helioz2000/OM345/OM345A/OM345A1_Back.png

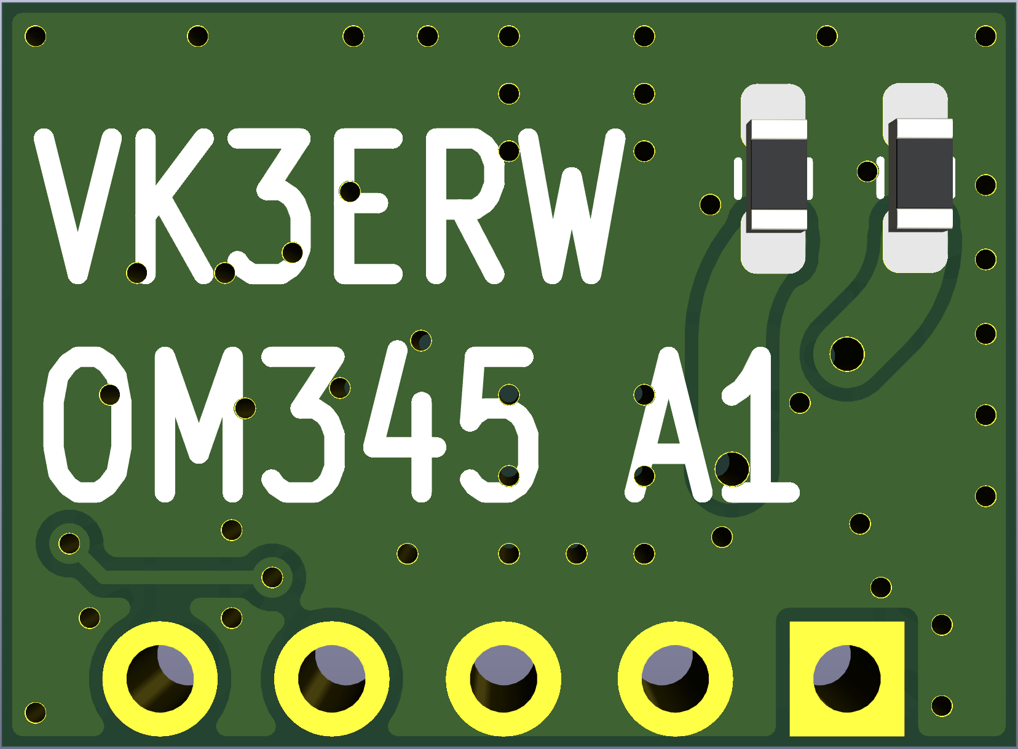
OM345A/OM345A1_Back.png
