helioz2000/OM345/OM345B/OM345B1_Front.png

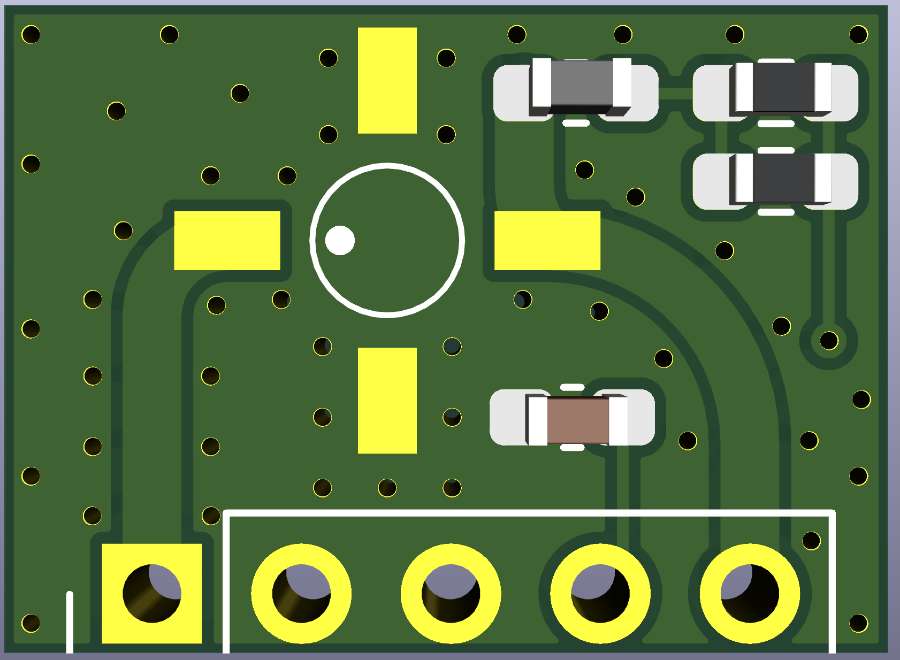
OM345B/OM345B1_Front.png
