helioz2000/OM345/OM345B/OM345B.kicad_pcb

## KiCad design OM345B/OM345B.kicad_pcb (2026-09-04)

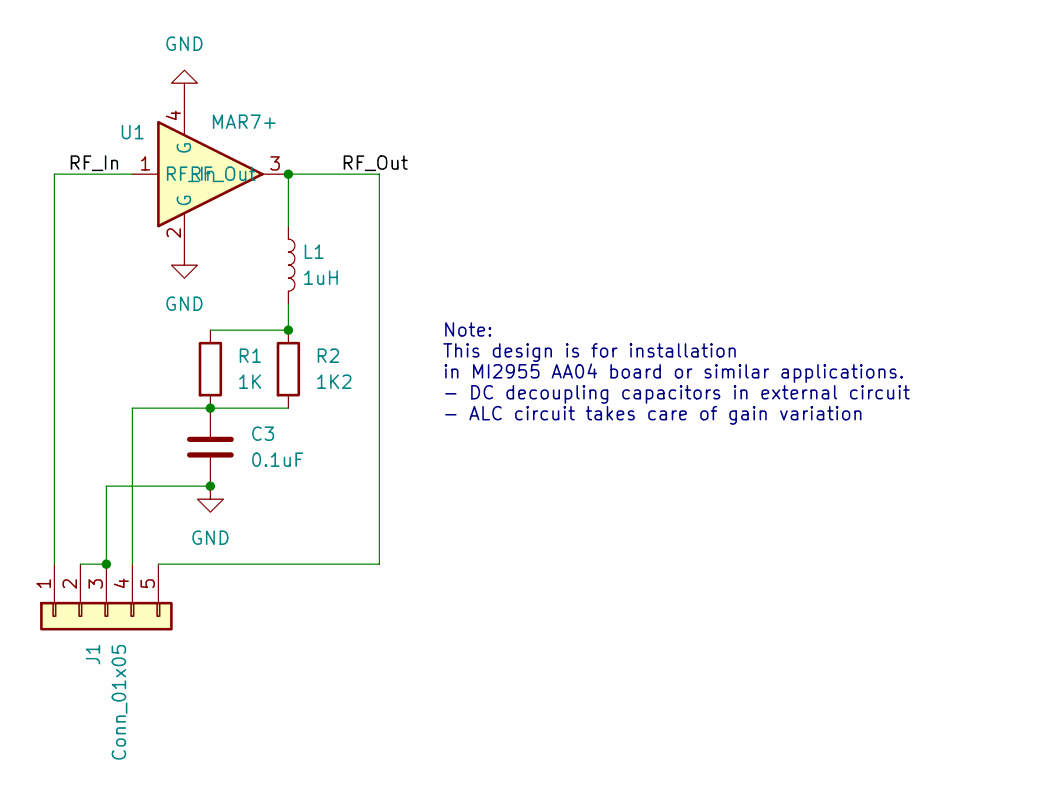
[picture p5: schematic OM345B.kicad_sch, OM345 Replacement B]

Parts:
C3: 0.1uF; C_0603_1608Metric_Pad1.08x0.95mm_HandSolder
J1: Conn_01x05; PinHeader_1x05_P2.54mm_Vertical
L1: 1uH; L_0603_1608Metric_Pad1.05x0.95mm_HandSolder
R1: 1K; R_0603_1608Metric_Pad0.98x0.95mm_HandSolder
R2: 1K2; R_0603_1608Metric_Pad0.98x0.95mm_HandSolder
U1: MAR7+; VV105

Connections:
/RF_In: J1.1, U1.1 (RF_In)
/RF_Out: J1.5, L1.1, U1.3 (RF_Out)
GND: C3.2, J1.2, J1.3, U1.2 (G), U1.4 (G)
unnamed: C3.1, J1.4, R1.2, R2.2
unnamed: L1.2, R1.1, R2.1

Notes on the sheet:
Note: This design is for installation in MI2955 AA04 board or similar applications. - DC decoupling capacitors in external circuit - ALC circuit takes care of gain variation

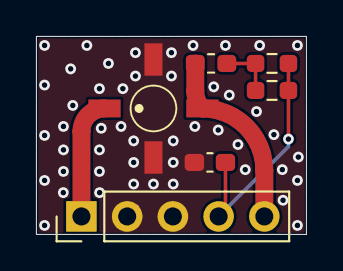
[picture p6: board OM345B.kicad_pcb from above]

Board: 2 copper layers, 15.0 x 11.0 mm, 6 parts (0 on the bottom side), 5 nets.
