helioz2000/OM345/OM345A/OM345A.kicad_pcb

## KiCad design OM345A/OM345A.kicad_pcb (2026-09-04)

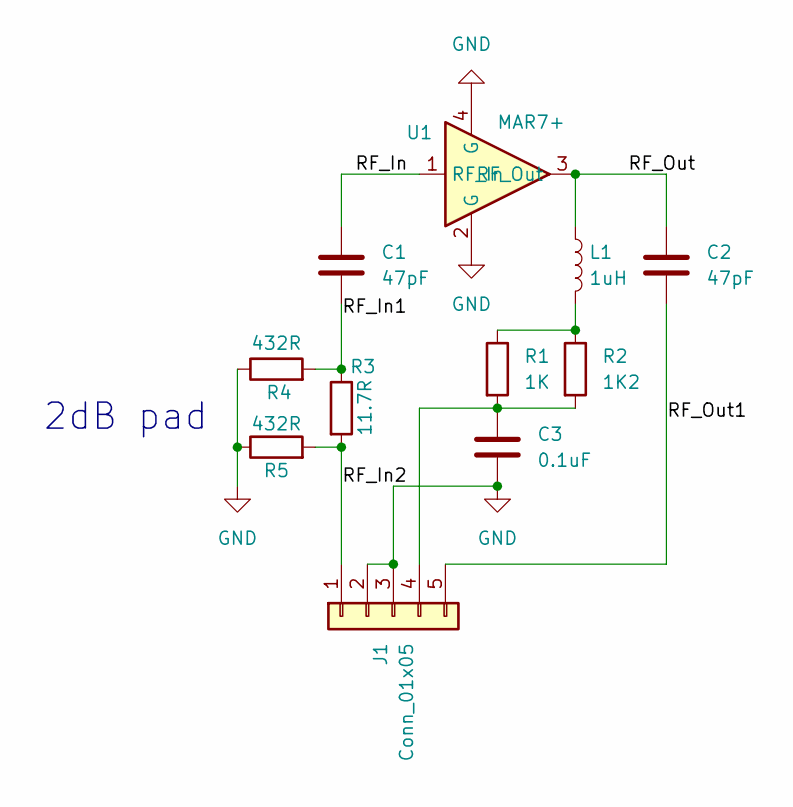
[picture p7: schematic OM345A.kicad_sch, OM345 Replacement A]

Parts:
C1, C2: 47pF; C_0603_1608Metric_Pad1.08x0.95mm_HandSolder
C3: 0.1uF; C_0603_1608Metric_Pad1.08x0.95mm_HandSolder
J1: Conn_01x05; PinHeader_1x05_P2.54mm_Vertical
L1: 1uH; L_0603_1608Metric_Pad1.05x0.95mm_HandSolder
R1: 1K; R_0603_1608Metric_Pad0.98x0.95mm_HandSolder
R2: 1K2; R_0603_1608Metric_Pad0.98x0.95mm_HandSolder
R3: 11.7R; R_0603_1608Metric_Pad0.98x0.95mm_HandSolder
R4, R5: 432R; R_0603_1608Metric_Pad0.98x0.95mm_HandSolder
U1: MAR7+; VV105

Connections:
/RF_In: C1.1, U1.1 (RF_In)
/RF_In1: C1.2, R3.1, R4.2
/RF_In2: J1.1, R3.2, R5.2
/RF_Out: C2.1, L1.1, U1.3 (RF_Out)
/RF_Out1: C2.2, J1.5
GND: C3.2, J1.2, J1.3, R4.1, R5.1, U1.2 (G), U1.4 (G)
unnamed: C3.1, J1.4, R1.2, R2.2
unnamed: L1.2, R1.1, R2.1

Notes on the sheet:
2dB pad

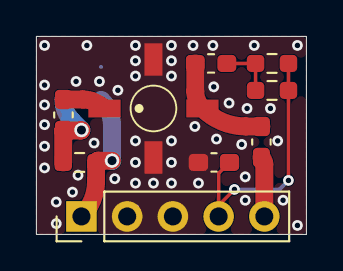
[picture p8: board OM345A.kicad_pcb from above]

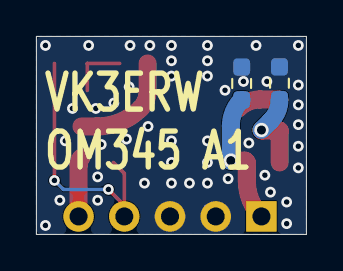
[picture p9: board OM345A.kicad_pcb from below]

Board: 2 copper layers, 15.0 x 11.0 mm, 11 parts (2 on the bottom side), 8 nets.
